arenibProjects/vive-tracker/README.md

# vive-tracker

This repository contains followings folders :
 - cad : 3d models of the beacons and the lighthouse (Solidworks 2016 format)
 - docs : datasheets, reports, ...
 - eda : BOM/Gerber files for PCBs
 - imgs : images for reports
