arenibProjects/vive-tracker/docs/reports/v1.0/report.tex

\documentclass[10pt,a4paper,french]{report}

\usepackage{fontspec}
\usepackage{xunicode}
\usepackage{babel}
\usepackage{graphicx}

\usepackage{amsthm}
\usepackage{amsmath}
\usepackage{amssymb}
\usepackage{mathrsfs}

\usepackage{geometry}
\geometry{top=2cm, bottom=2cm, left=2cm , right=2cm}

\title{Système de positionnement d'un robot mobile basé sur le HTC Vive (technologie Lighthouse)}
\author{Evan \bsc{Roué}}
\date{2017 - 2018}

\begin{document}
\maketitle

\input{./abstract.tex}

\tableofcontents

\thispagestyle{empty}
\setcounter{page}{0}

\chapter{Introduction}
\input{./introduction.tex}

\chapter{La technologie Lighthouse}
\input{./lighthouse.tex}

\chapter{Le système Vive pour robots}
\input{./design.tex}

\chapter{Tests}
\input{./tests.tex}

\chapter{Retour après la coupe 2018}
\input{./aftercdr2018.tex}

\chapter{Conclusion}
\input{./conclusion.tex}

\end{document}
