arenibProjects/vive-tracker/docs/reports/v1.0/lighthouse.tex

La technologie lighthouse est une technologie de positionnement 3d précis au millimètre près par réception de balayage laser infrarouge initialement conçu pour le HTC Vive.

Elle repose sur le principe d'un phare (lighthouse en anglais) à 2 faisceaux : deux lasers infrarouges diffusés sous forme de plaques balayent la zone de jeu à une fréquence de 60Hz chacun. Avant chaque balayage, un flash lumineux Des récepteurs infrarouges placés sur le casque et les manettes permettent de récupérer ces balayages.
