arenibProjects/vive-tracker/cad/iroise/dark.png

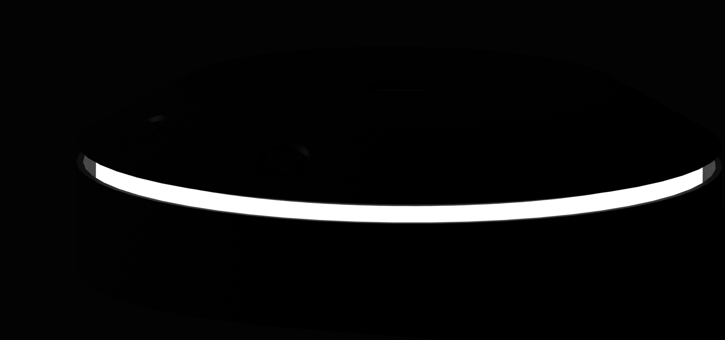
cad/iroise/dark.png
