arenibProjects/vive-tracker/cad/iroise/light.png

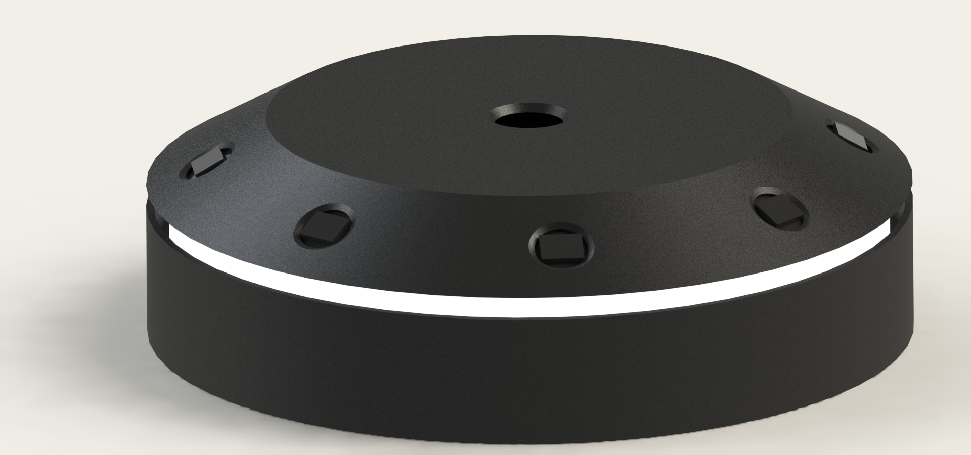
cad/iroise/light.png
