arenibProjects/vive-tracker/docs/reports/v1.0/imgs/IRoise_top.png

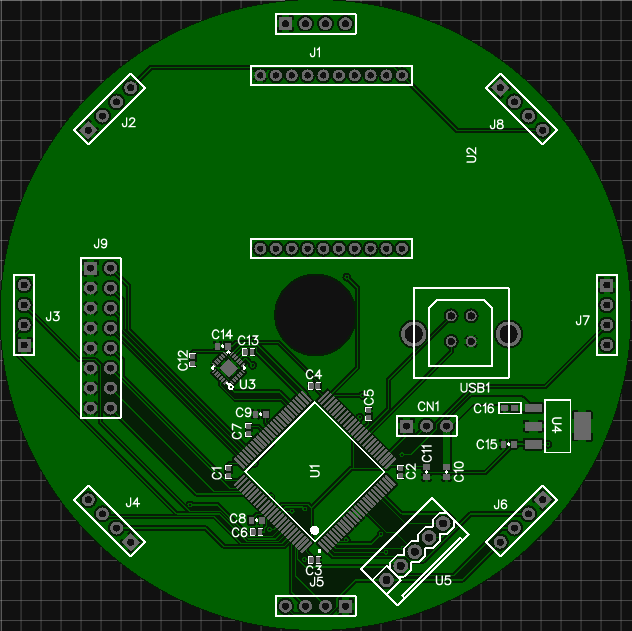
docs/reports/v1.0/imgs/IRoise_top.png
