arenibProjects/vive-tracker/docs/reports/v1.0/imgs/VIVETrackersPCBs.jpg

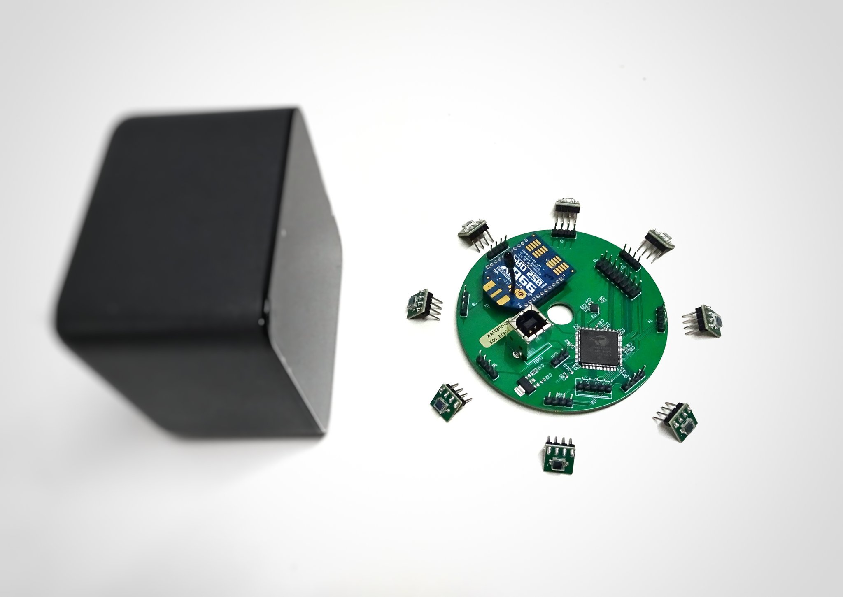
docs/reports/v1.0/imgs/VIVETrackersPCBs.jpg
