arenibProjects/vive-tracker/eda/IRoise/IRoise_bottom.png

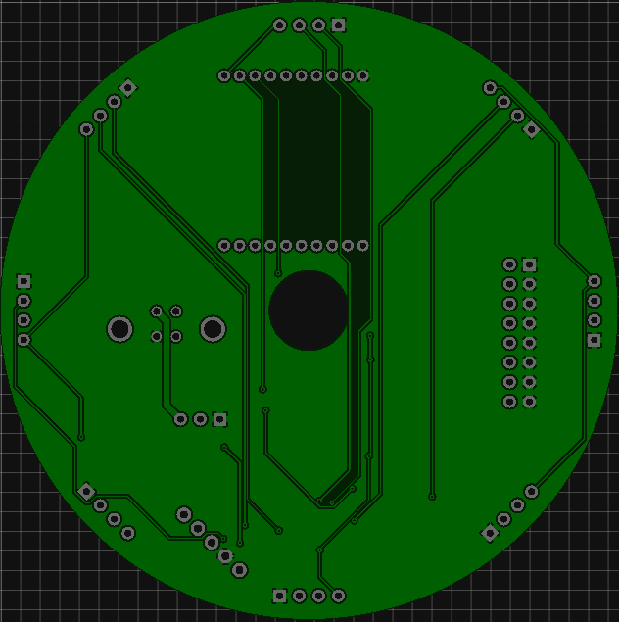
eda/IRoise/IRoise_bottom.png
