arenibProjects/vive-tracker/eda/IRoise/TS4231 orientation.png

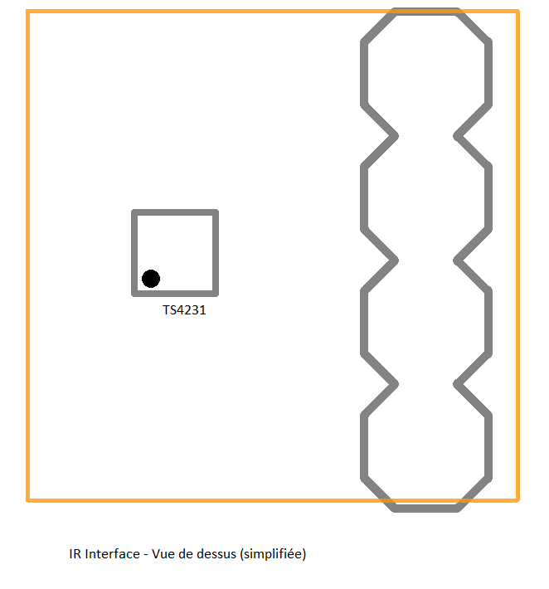
eda/IRoise/TS4231 orientation.png
