arenibProjects/vive-tracker/imgs/1-LED_Timing_Decoder.png

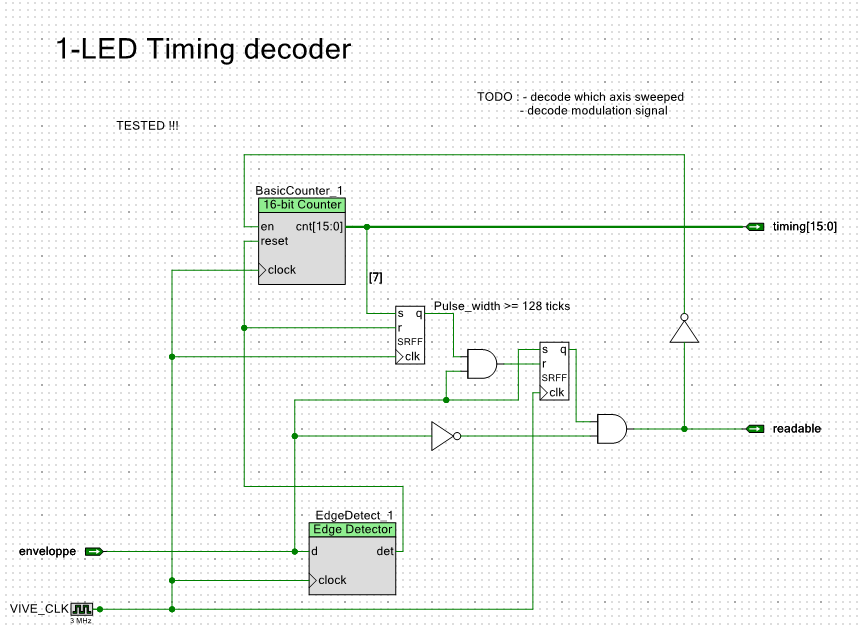
imgs/1-LED_Timing_Decoder.png
