arenibProjects/vive-tracker/docs/beacons geometry sheet.ods

Dim carte coté | 100 | mm | Largeur basse de captation | 41,4213562373 | mm
Angle capteurs | 30 | deg | Dimension rectangle haut | 75,751288694 | mm
Longueur pente | 14 | mm | Largeur haute de captation | 31,3772111443 | mm
