arenibProjects/vive-tracker/cad/lighthouse/Assemblage.SLDASM

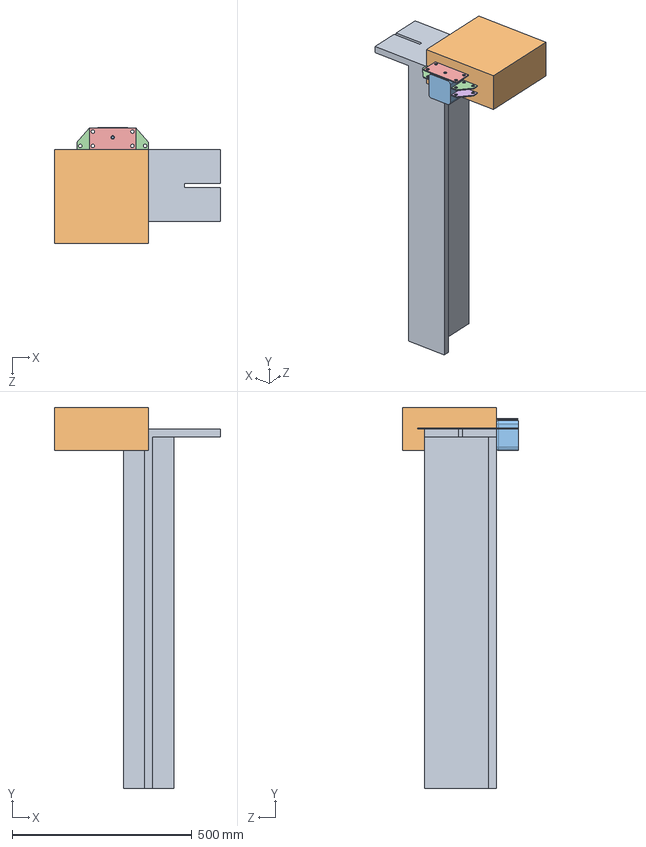
[picture p9: CAD file, 2018-05-08]
cad/lighthouse/Assemblage.SLDASM
462.0 x 1060.0 x 324.0 mm
mat
bounding box
beacon x 2
plaque
plaque_vive x 2
plaque_bottom
