arenibProjects/vive-tracker/cad/iroise/boite1.SLDASM

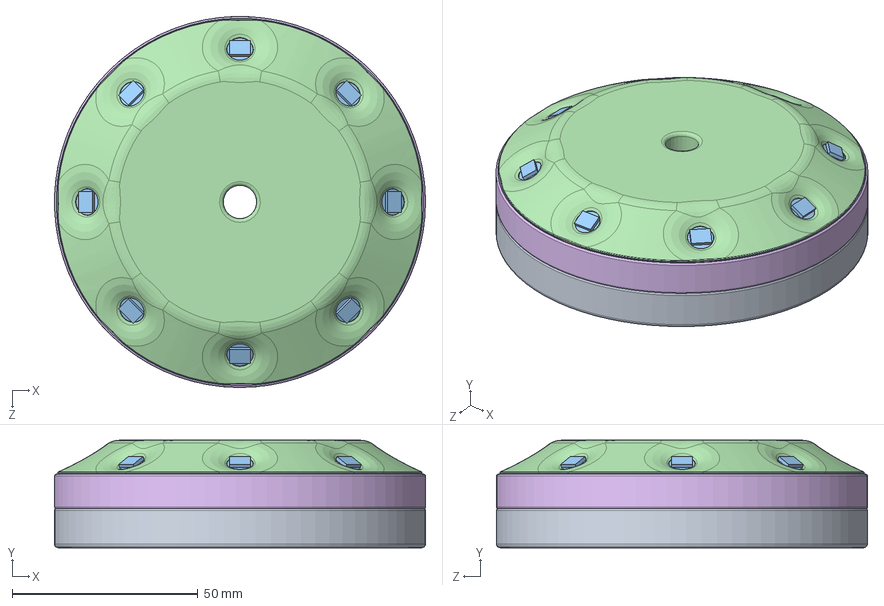
[picture p10: CAD file, 2018-05-08]
cad/iroise/boite1.SLDASM
100.0 x 29.0 x 100.0 mm
bottom
neopix
diode x 8
top
board
channel
