arenibProjects/vive-tracker/cad/iroise/board.SLDPRT

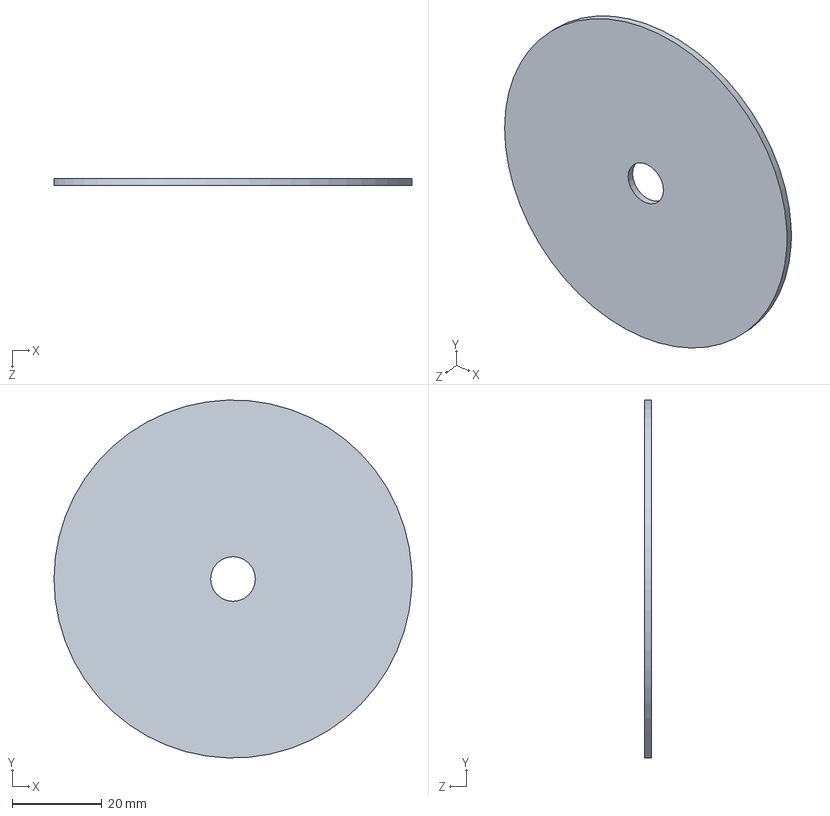
[picture p11: CAD file, 2018-05-08]
cad/iroise/board.SLDPRT
80.0 x 80.0 x 1.60 mm
