arenibProjects/vive-tracker/cad/lighthouse/mat.SLDPRT

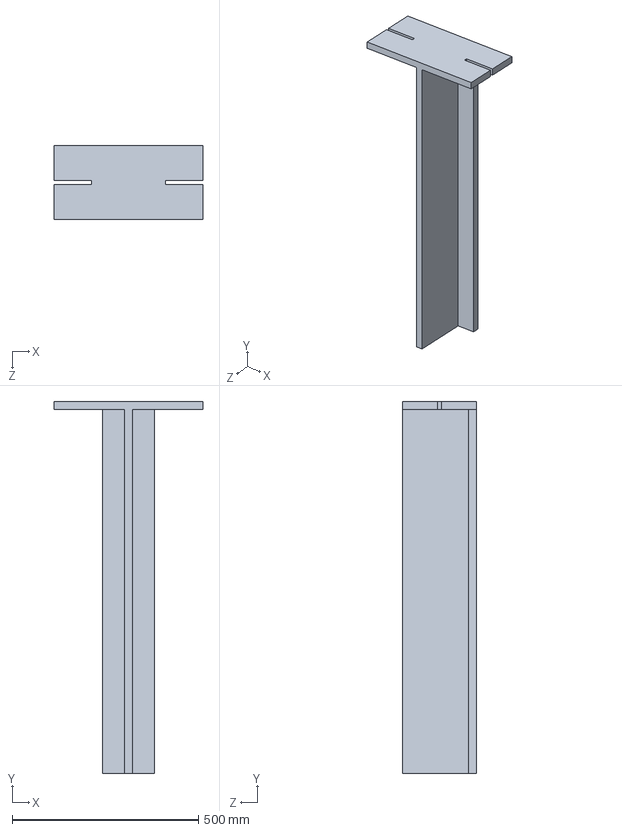
[picture p12: CAD file, 2018-05-08]
cad/lighthouse/mat.SLDPRT
400.0 x 1000.0 x 200.0 mm
