arenibProjects/vive-tracker/cad/lighthouse/plaque_vive.SLDPRT

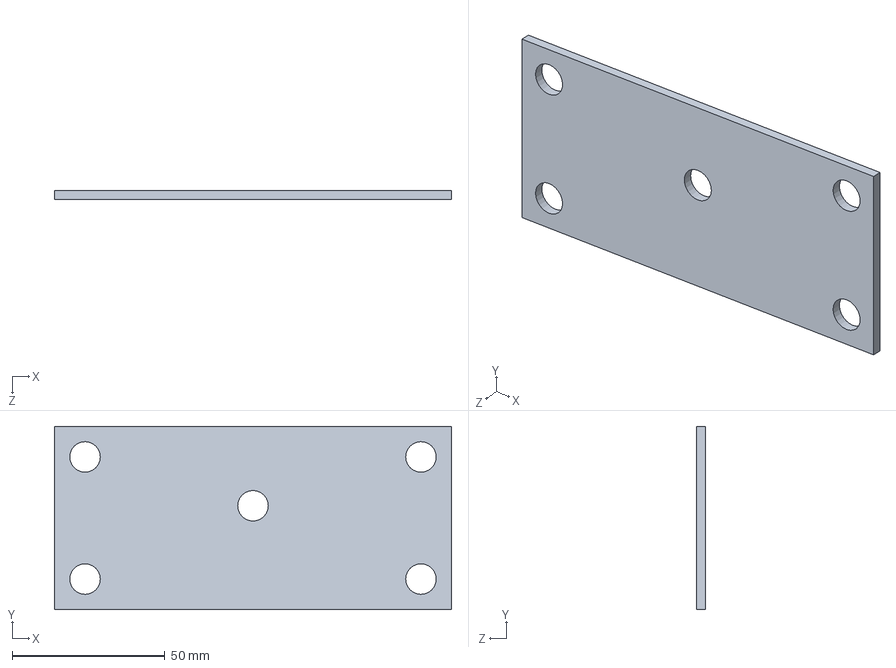
[picture p13: CAD file, 2018-05-08]
cad/lighthouse/plaque_vive.SLDPRT
130.0 x 60.0 x 3.00 mm
