arenibProjects/vive-tracker/cad/iroise/boundingbox_iroise.SLDPRT

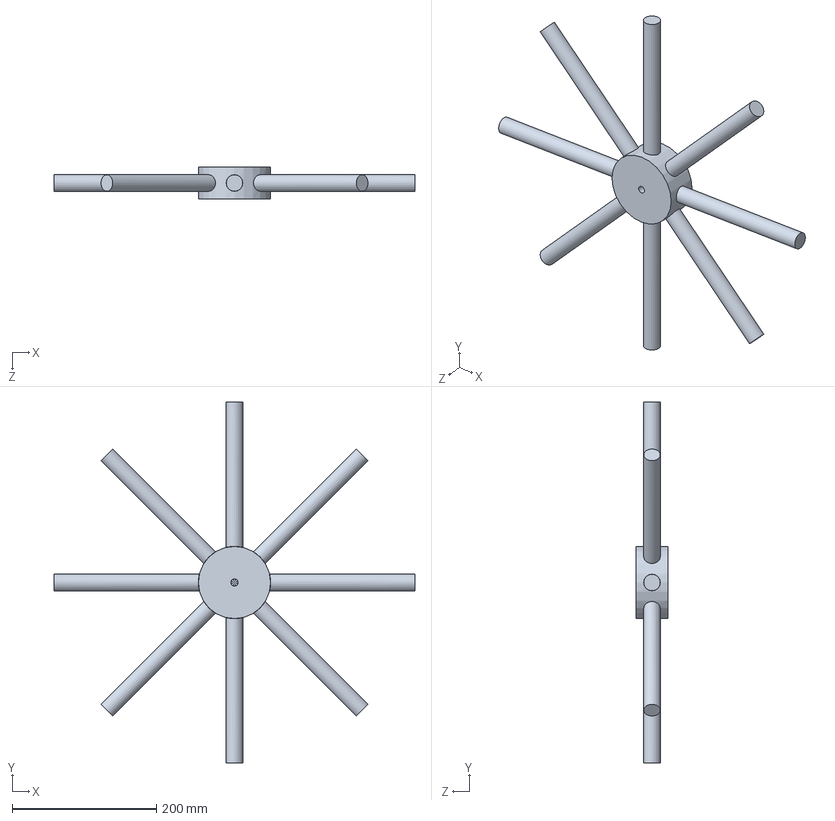
[picture p14: CAD file, 2018-05-08]
cad/iroise/boundingbox_iroise.SLDPRT
500.0 x 500.0 x 45.0 mm
