arenibProjects/vive-tracker/cad/lighthouse/bounding box.SLDPRT

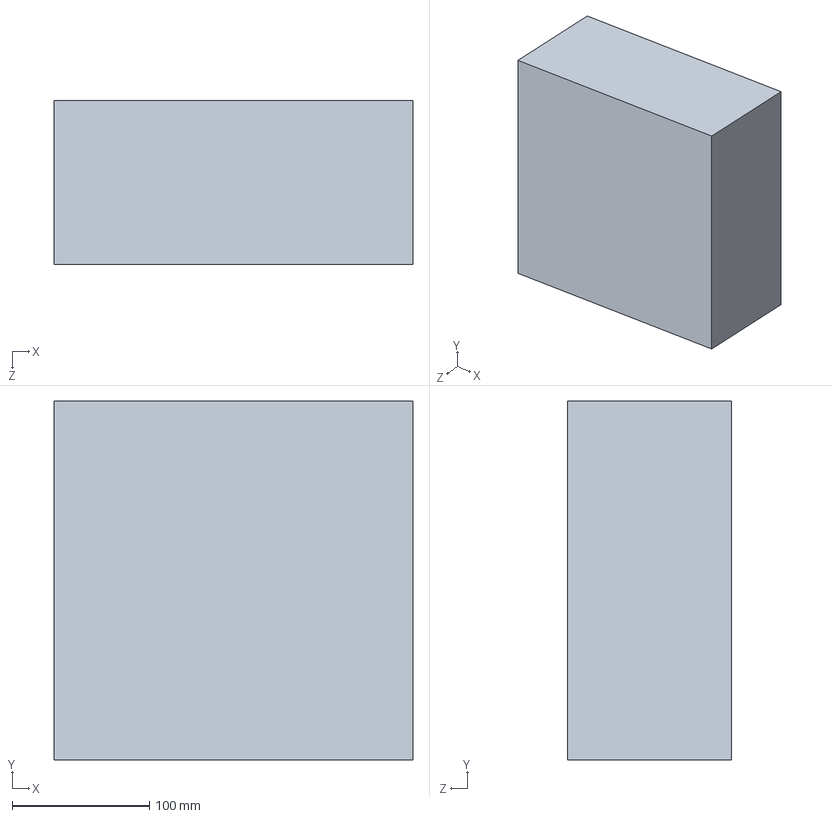
[picture p15: CAD file, 2018-05-08]
cad/lighthouse/bounding box.SLDPRT
262.0 x 262.0 x 120.0 mm
