arenibProjects/vive-tracker/cad/iroise/top.SLDPRT

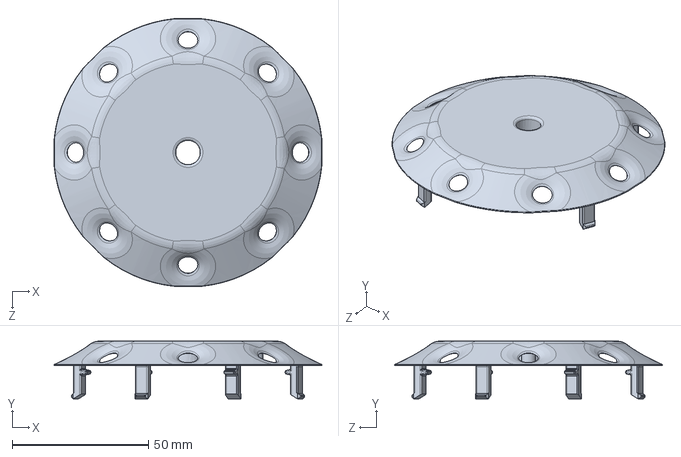
[picture p16: CAD file, 2018-05-08]
cad/iroise/top.SLDPRT
98.2 x 21.2 x 98.2 mm
