arenibProjects/vive-tracker/cad/lighthouse/plaque_bottom.SLDPRT

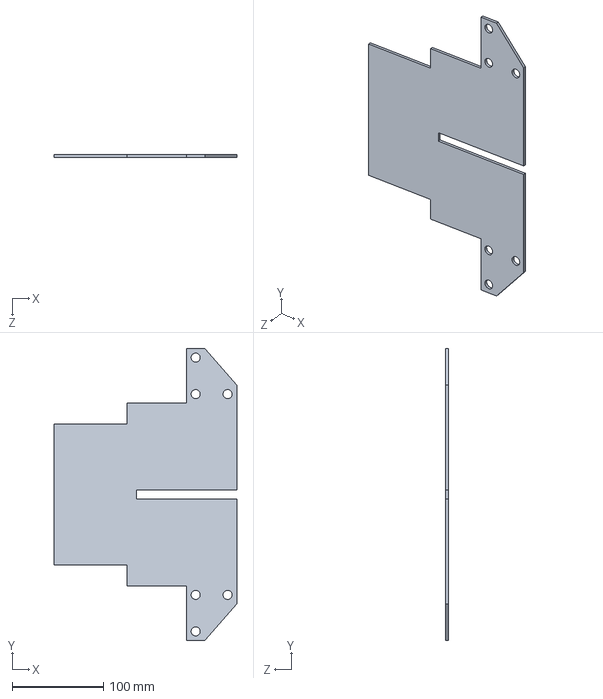
[picture p17: CAD file, 2018-05-08]
cad/lighthouse/plaque_bottom.SLDPRT
200.0 x 320.0 x 3.00 mm
