arenibProjects/vive-tracker/cad/iroise/channel.SLDPRT

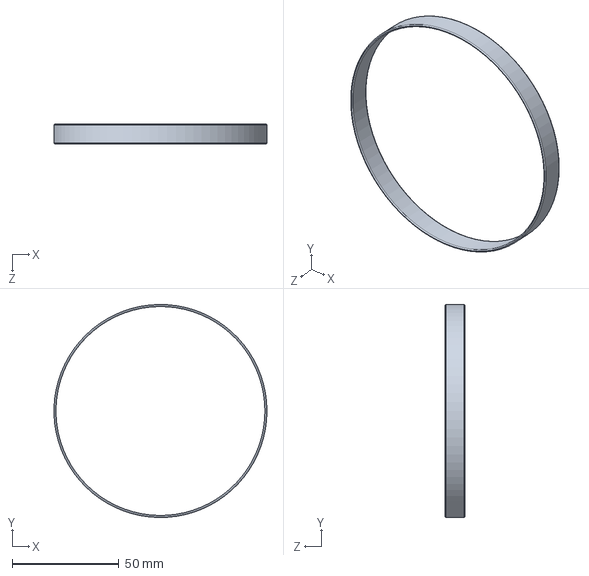
[picture p18: CAD file, 2018-05-08]
cad/iroise/channel.SLDPRT
100.0 x 100.0 x 9.35 mm
