arenibProjects/vive-tracker/cad/lighthouse/plaque.SLDPRT

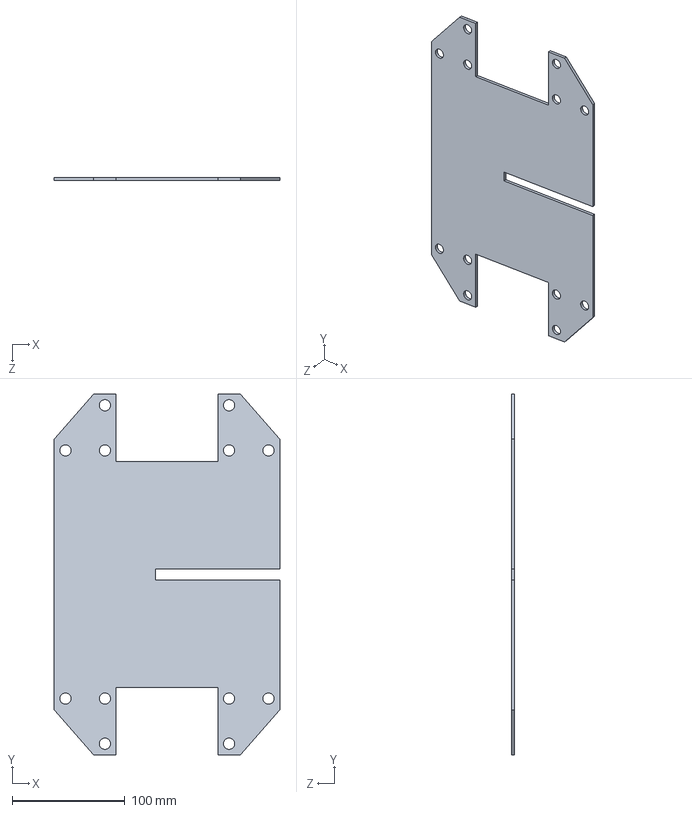
[picture p19: CAD file, 2018-05-08]
cad/lighthouse/plaque.SLDPRT
200.0 x 320.0 x 3.00 mm
