arenibProjects/vive-tracker/cad/iroise/bottom.SLDPRT

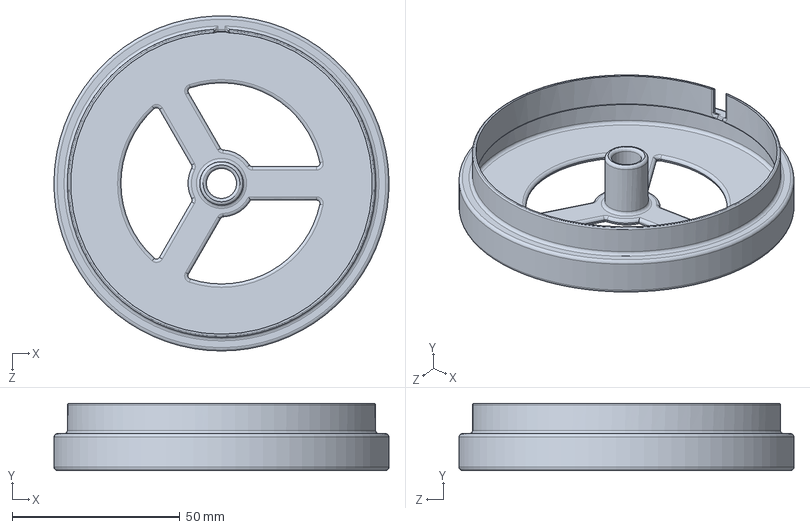
[picture p20: CAD file, 2018-05-08]
cad/iroise/bottom.SLDPRT
100.0 x 20.0 x 100.0 mm
