arenibProjects/vive-tracker/cad/lighthouse/beacon.SLDPRT

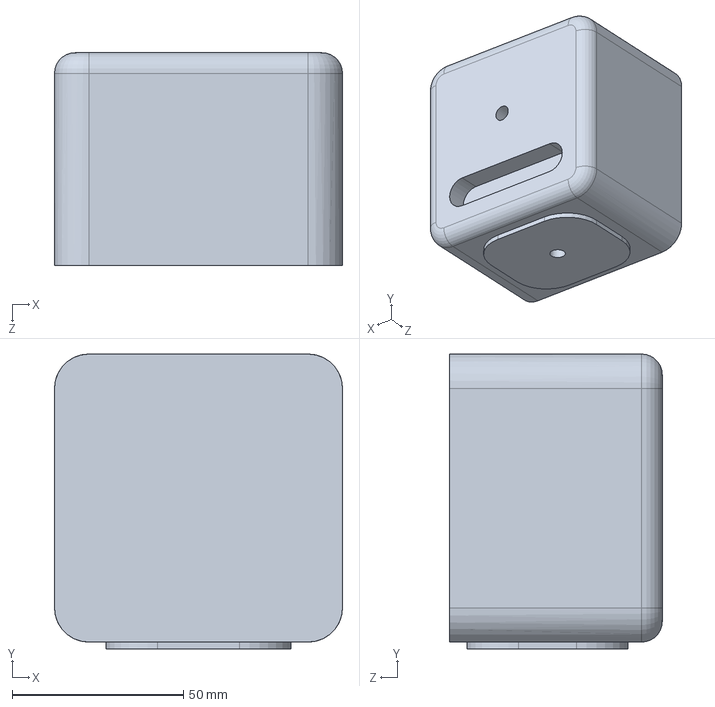
[picture p21: CAD file, 2017-12-12]
cad/lighthouse/beacon.SLDPRT
84.0 x 86.0 x 62.0 mm
