arenibProjects/vive-tracker/cad/iroise/diode.SLDPRT

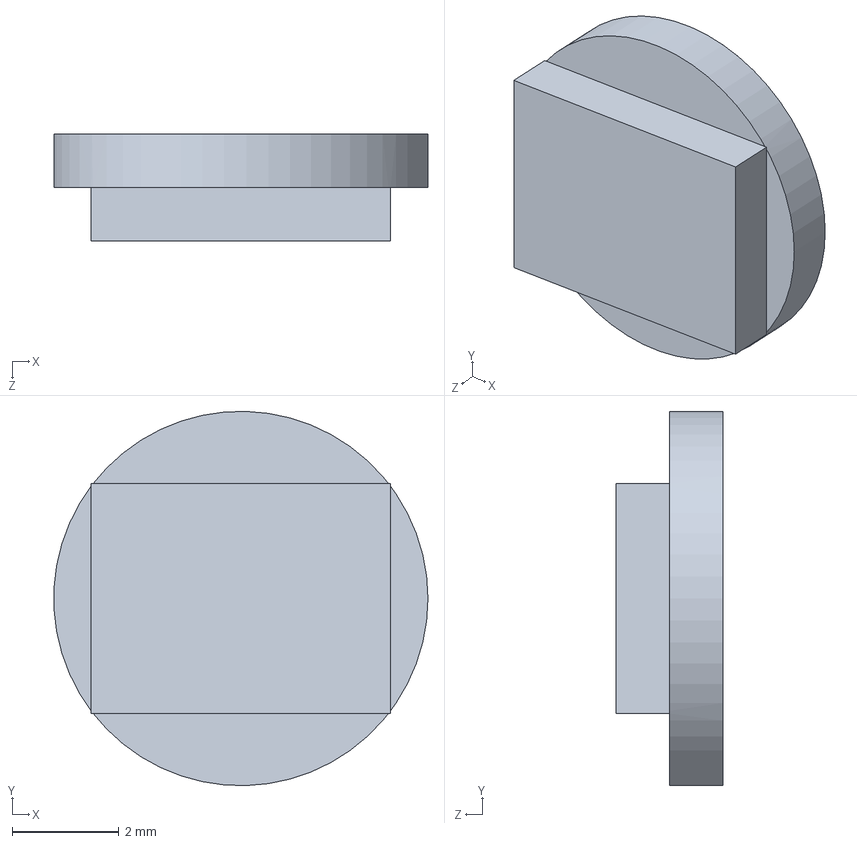
[picture p22: CAD file, 2018-05-08]
cad/iroise/diode.SLDPRT
6.99 x 7.00 x 2.00 mm
