arenibProjects/vive-tracker/cad/iroise/neopix.SLDPRT

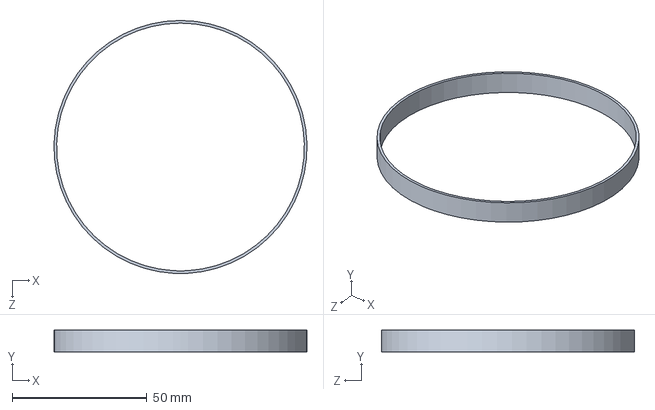
[picture p23: CAD file, 2018-05-08]
cad/iroise/neopix.SLDPRT
94.0 x 8.00 x 94.0 mm
