arenibProjects/vive-tracker/(list of files, cad)

Other CAD files:
cad/iroise/iroise_board.dxf
cad/iroise/bottom.STL
cad/iroise/channel.STL
cad/iroise/top.STL
