arenibProjects/vive-tracker/eda/IRoise/IRInterface.brd

## EAGLE design eda/IRoise/IRInterface.brd (2017-12-20)

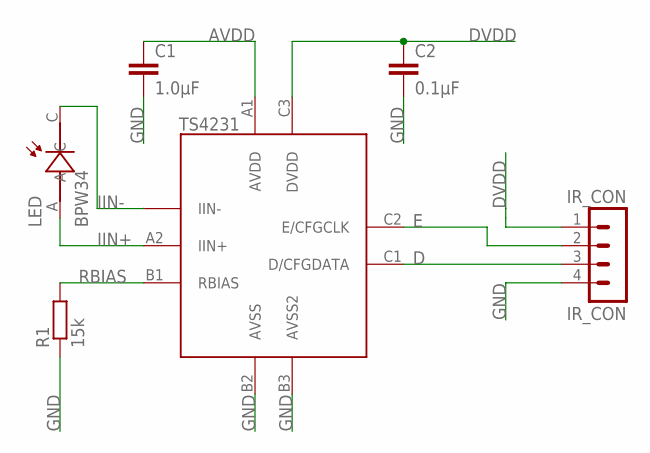
[picture p24: schematic IRInterface.sch]

Parts:
C1: 1.0µF; C0402
C2: 0.1µF; C0402
IR_CON: IR_CON; MA04-1
LED: BPW34; PHODET_BPW34
R1: 15k; R0402
TS4231: TS4231SMD-9; WLCSP-9

Connections:
AVDD: C1.1, TS4231.A1 (AVDD)
D: IR_CON.3, TS4231.C1 (D/CFGDATA)
DVDD: C2.1, IR_CON.1, TS4231.C3 (DVDD)
E: IR_CON.2, TS4231.C2 (E/CFGCLK)
GND: C1.2, C2.2, IR_CON.4, R1.1, TS4231.B2 (AVSS), TS4231.B3 (AVSS2)
IIN+: LED.A, TS4231.A2 (IIN+)
IIN-: LED.C, TS4231.A3 (IIN-)
RBIAS: R1.2, TS4231.B1 (RBIAS)

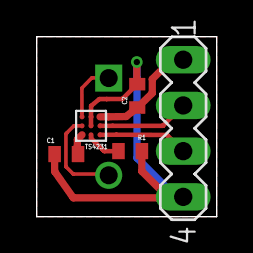
[picture p25: board IRInterface.brd from above]

Board: 2 copper layers, 10.0 x 10.0 mm, 6 parts (1 on the bottom side), 8 nets.
