arenibProjects/vive-tracker/(commit log)

2017-12-20 Add IRInterface eagle files
    [IRInterface.brd, IRInterface.sch]
2018-01-22 VIVEDecoder architecture update with addition of XBEE and IMU communication peripherals
    This architecture is more resilient if there's an light occlusion when the sensor is in counting state. Pulse length decoding will be done in software because some datapath ressources were moved from pulse length decoding to the protection.
    Adding UART peripheral for XBEE communication.
    Adding I2C Master peripheral for IMU communication.
2018-01-22 Add a kalman filter test Scilab script
2018-02-23 Create VIVE_Sensors module and Hardware design correction
    Create VIVE_Sensors module and and correction of hardware design after some tests.
    [main.c, vive_sensors.c, vive_sensors.h]
2018-02-25 [BUGFIX] DMA
    Change DMA source adress.
    [main.c, vive_sensors.h]
2018-03-07 Add TS4231_driver module
    This module is an portage of TS4231 Arduino Library from Triad Semiconductors (https://github.com/TriadSemi/TS4231) on the PSoC 5LP.
    This module allows us to :
    - Correctly configure the TS4231 chip.
    - Switch between SLEEP and WATCH mode dynamically to save power.
    This commit also provides a little code to test it.
    [TS4231_driver.c, TS4231_driver.h, main.c]
2018-03-29 Add configuration.h file
    [configuration.h]
2018-04-05 5th April 2018's commit
    This commit includes :
    - VIVEDecoder readable bit debugging
    - VIVE_sensors module debugging
    - Code reorganization
    - Add a time timer
    [configuration.h]
2018-04-05 Axis of AWESOME !
    [configuration.h]
2018-04-08 VIVE_sensors module correction
    - Forgot one DMA transfert.
    - Better voting system
    [vive_sensors.c]
2018-04-08 LEDs Positions done !
    With temporary LEDPOS command implemented.
2018-04-08 Add beacon configuration lines
    [configuration.h]
2018-04-10 Add tracker led offset in configuration.h
    [configuration.h]
2018-04-10 Switch to pointer for led_positions in find_position method
2018-04-10 lighthouse support v1 and iroise files
    [Assemblage.SLDASM, boite1.SLDASM, bottom.SLDPRT, bottom.STL, bounding box.SLDPRT, boundingbox_iroise.SLDPRT, diode.SLDPRT, iroise_board.dxf]
2018-04-11 iroise reiforced
    [boite1.SLDASM, bottom.SLDPRT, diode.SLDPRT, neopix.SLDPRT, top.SLDPRT]
2018-04-11 HEADING working
    [configuration.h]
2018-04-11 iroise support and aesthetic update
    missing tabs
    [boite1.SLDASM, bottom.SLDPRT, diode.SLDPRT, top.SLDPRT]
2018-04-11 iroise tabs
    [boite1.SLDASM, bottom.SLDPRT, top.SLDPRT]
2018-04-11 iroise stl export
    [bottom.STL, top.STL]
2018-04-15 update iroise top holder
    [board.SLDPRT, boite1.SLDASM, bottom.SLDPRT, bottom.STL, channel.SLDPRT, channel.STL, top.SLDPRT, top.STL]
2018-04-17 Correction of NaN bugs and switch to a median filter instead of an average filter
    [Position_finder.c, Position_finder.h]
2018-04-17 Correction after some IRInterface destruction
    "Correction of NaN bugs and switch to a median filter instead of an average filter" commit is also concerned.
    [vive_sensors.c]
2018-04-21 X and Y coordinates computation with median filter
2018-05-02 Add UART_commands_manager module
    Allows Teensy or any Arduino-like computer to communicate with the vive tracker without hosting an USB connection.
2018-05-02 Refactoring code
    [configuration.h]
2018-05-02 [BUGFIX] Plugged an issue
    malloc() and free() : Well, it's always better together
    [Position_finder.c]
2018-05-08 Modif' pour découpe laser
    [Assemblage.SLDASM, plaque.SLDPRT, plaque_bottom.SLDPRT]
2018-05-23 Changes ocurred during the French national robotic cup
    [configuration.h]
2018-07-15 Add comments to the code
    Hopefully, this will helps users (or future mainteners) of this system to understand what the firmware does.
    [configuration.h]
